FogCast-Konstanz/weather-station-pico/README.md

# Raspberry Pi Pico 2 Wetterstation

Dieses Repository enthält den MicroPython-Code für eine autarke, modulare Wetterstation auf Basis des Raspberry Pi Pico 2. Das System erfasst Umweltparameter (Temperatur, Luftfeuchtigkeit, Luftdruck) sowie Bewegungsdaten (IMU) und berechnet einen dynamisch korrigierten UV-Index.

## 📂 Projektstruktur

* `main.py`: Die Hauptausführungsschleife (nicht-blockierend)[cite: 10].
* `config.py`: Zentrale Konfigurationsdatei für Intervalle, Standortdaten und Pin-Mappings.
* `drivers/`: Hardware-spezifische MicroPython-Treiber für AS7331, MPU6886, QMP6988, SHT30 sowie die Sonnenstandsberechnung[cite: 12, 13, 14, 15, 16].
* `tools/`: Hilfsskripte, insbesondere `i2c_pin_scan.py` zur Ermittlung verdeckter I²C-Pins am Grove Shield[cite: 9].
* `docs/`: Projektdokumentation, Hardware-Aufbau und Gehäuseskizzen.

## 🚀 Installation & Setup

1. **MicroPython flashen:** Stelle sicher, dass auf dem Pico 2 die aktuelle MicroPython-Firmware installiert ist.
2. **Dateien übertragen:** Öffne Thonny (oder ähnliches) und kopiere alle Dateien und Ordner (außer `.git` und `docs/`) auf das Hauptverzeichnis (`/`) des Pico 2.
3. **SoftI²C-Pins ermitteln:** Da die zweite Signalader bei den Grove-Ports `A2` (IMU) und `D20` (UV) je nach Shield variieren kann, führe einmalig das Diagnose-Skript aus:
   ```python
   import tools.i2c_pin_scan
   tools.i2c_pin_scan.find_sensor("A2", expected_address=0x68)
   tools.i2c_pin_scan.find_sensor("D20", expected_address=0x74)
4. **Messwerte überprüfen:** Wenn die Skripte auf den Pico hochgeladen sind, können die ersten Messwerte auf der Konsole von dem PC ausgegeben werden. Hierbei können die Messwerte auf realitätsnahe Werte überprüft werden.

## ⏭️ Aktueller Stand / Weitere Schritte für das kommende Team

Momentan befindet sich der Aufbau der Sensorenanlage in den finalen Schritten. 

### Montage

Die Montage der 3D-Druck Teile und den Sensoren wir in diesem Repository unter folgenden Link erläutert:
https://github.com/FogCast-Konstanz/weather-station-pico/tree/main/docs/3D-Druck_Aufbau

### Die Stromversorgung

- Verwendete Komponenten:
   - Mikrocontroller: **Raspberry Pi Pico 2** 
   - Schaltmodul: **Seeed Studio Grove 2-Kanal-Relaismodul** (im transparenten Schutzgehäuse).
      - Verwendet zwei Songle SRD-05VDC-SL-C Relais (5V-Spulenspannung).
      - Schalteleistung: max. 10 A bei 250 V AC (Wechselstrom) bzw. 10 A bei 30 V DC (Gleichstrom).

- Verbindung & Funktion:
   - Verkabelung: Das Relaismodul ist über ein 4-adriges Kabel (Signal, 5V, GND) mit einem Steckplatz des Pico-Shields verbunden.
   - Funktionsweise: Das Relais fungiert als elektronisch gesteuerter Schalter. Der Raspberry Pi Pico 2 kann über einen digitalen Ausgang ein Steuersignal an das Modul senden, um den Stromkreis auf der Lastseite (Schraubklemmen am Relais) zu schließen oder zu öffnen.
   - Sicherheit: Das Modul verfügt über eine integrierte Optokoppler-Isolierung, die den empfindlichen Mikrocontroller vor gefährlichen Spannungsspitzen und Rückströmen aus dem Laststromkreis schützt.
   - Bei einer vollständigen Verbindung zwischen dem Raspberry Pi Pico 2 und dem Seeed Studio Grove 2-Kanal-Relaismodul kann diese an ein herkömmliches Stromnetz (230 V) angeschlossen werden. Dazu haben wir auf dem F-Gebäude Dach an der mittleren Plattform ein Stromkabel verlegt, der die Sensoranlage / Ceilometer damit bedienen soll.

### Die Sensoren sind mit dem Raspberry Pi Pico 2 wie folgt verbunden:

| Sensor | Grove-Port | Pico-GPIO (SDA / SCL) | Bus-Typ |
| :--- | :--- | :--- | :--- |
| SHT30 (intern) | I2C0 | GP8 / GP9 | Hardware I2C(0) |
| QMP6988 | I2C0 | GP8 / GP9 | Hardware I2C(0) |
| SHT30 (extern) | I2C1 | GP6 / GP7 | Hardware I2C(1) |
| MPU6886 (IMU) | A2 | GP28 / `<config.MPU6886_SCL_PIN>` | SoftI2C |
| AS7331 (UV) | D20 | GP20 / `<config.AS7331_SCL_PIN>` | SoftI2C |

Diese Verkabelung ist in 'main.py' im Code wiederzufinden, dementsprechend kann man dies im Code und physisch verändern, wenn man das möchte.

### Datenübertragung

Zusammen mit der zuständigen Abteilung der HTWG haben wir ein LAN-Kabel für die Datenübertragung vom F-Gebäude-Dach in den Raum **F-222** gelegt. Für den Zugang zu dem Raum ist Prof. Rebholz unsere Ansprechperson gewesen. Der Zugang wurde über den Anschluss **C 10 C2** für das HTWG-Netzwerk freigelegt, für eine problemlose Datenübertragung. Leider konnten wir diese Datenübertragung noch nicht testen. Hierfür war *Robert Breuer* ein guter Ansprechpartner und könnte für die Implementierung vermutlich eine große Hilfe sein. Die Netzwerk Config, die man beim Raspberry Pi dafür setzen muss lautet:
- **141.37.159.38/22**
- **141.37.156.254**

Wenn man die Config einstellt und die Hardware dementsprechend ans Netzwerk anschließt sollte die Verbindung aufgebaut werden können. Diese Daten können dann abgerufen und in die Datenbank eingepflegt werden.

### 🔌 Ersatzlösung: Standalone-Anbindung via USB & InfluxDB

Da aktuell kein bzw. bedingt das Ceilometer zur Verfügung steht, kann die Pico-2-Wetterstation bis zur finalen Integration über eine lokale USB-Schnittstelle direkt an den Raspberry Pi einer bestehenden Wetterstation angebunden werden.

1. Datenquelle (Pico 2): Die main.py auf dem Pico 2 gibt die gemessenen und korrigierten Sensordaten (UV-Index, Temperatur, Feuchte, Luftdruck, IMU) bei jeder Messrunde als JSON- bzw. Key-Value-String über die serielle USB-Schnittstelle (sys.stdout) aus.
2. Datenempfänger (Raspberry Pi Host): Der Raspberry Pi der bestehenden Wetterstation ist per USB-Kabel mit dem Pico 2 verbunden.
3. Bridge-Dienst: Ein kleiner Python-Background-Dienst (Daemon/Systemd-Service) auf dem Raspberry Pi liest den seriellen Port (/dev/ttyACM0) kontinuierlich aus und parst die eintreffenden Messwerte.
4. Persistierung: Der Dienst schreibt die strukturierten Datensätze direkt in die lokale oder netzwerkbasierte InfluxDB-Instanz der Wetterstation.

Architektur der Ersatzlösung:

```text
+-----------------------+     USB (Serial)     +-----------------------+    (Daemon Script)    +------------------+
| Raspberry Pi Pico 2   | -------------------> | Raspberry Pi (Host)   | --------------------> | InfluxDB         |
| (Wetterstation Code)  |                      | /dev/ttyACM0          |                       | (Datenbank)      |
+-----------------------+                      +-----------------------+                       +------------------+
```

Schritt-für-Schritt Einrichtung auf dem Raspberry Pi Host findet man unter dem Ordner: **without_ceilometer**
