FogCast-Konstanz/weather-station-pico/docs/Skizze_grober_Software-Ablauf.png

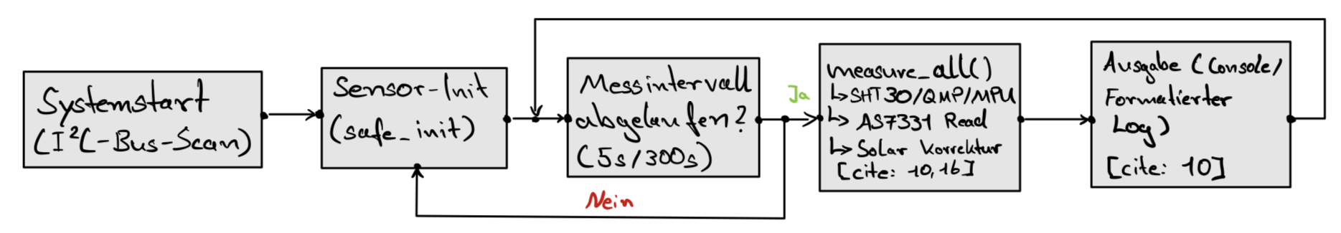
docs/Skizze_grober_Software-Ablauf.png
