FogCast-Konstanz/weather-station-pico/docs/3D-Druck_Aufbau/3D-Druckteile_AS7331/Halterung_fuer_UV-Sensor.STL-Körper.stl

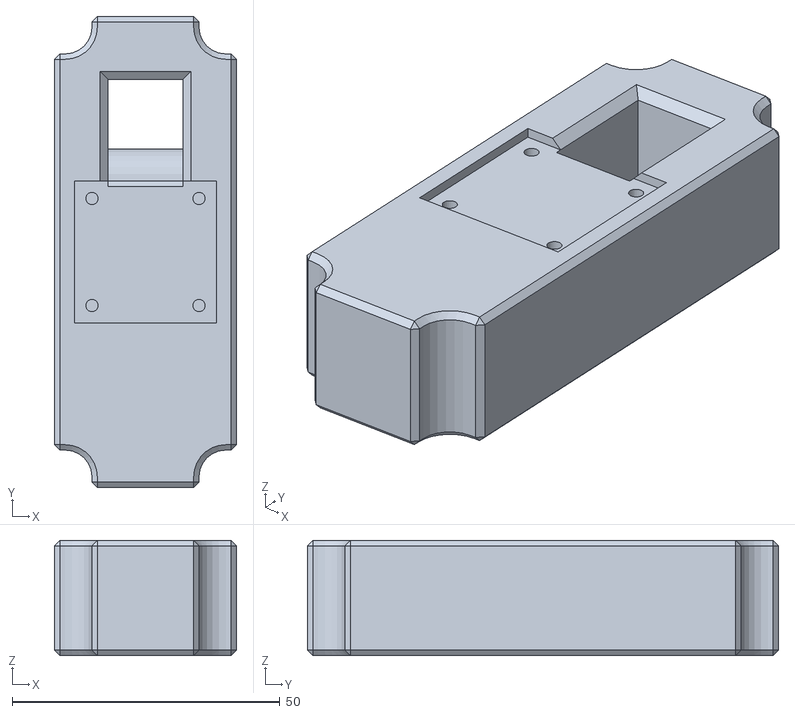
[picture p4: CAD file, 2026-09-01]
docs/3D-Druck_Aufbau/3D-Druckteile_AS7331/Halterung_fuer_UV-Sensor.STL-Körper.stl
34.0 x 88.0 x 21.5
