FogCast-Konstanz/weather-station-pico/docs/3D-Druck_Aufbau/3D-Druckteile_SHT30/Flansch_Lufttemperatursensor.stl

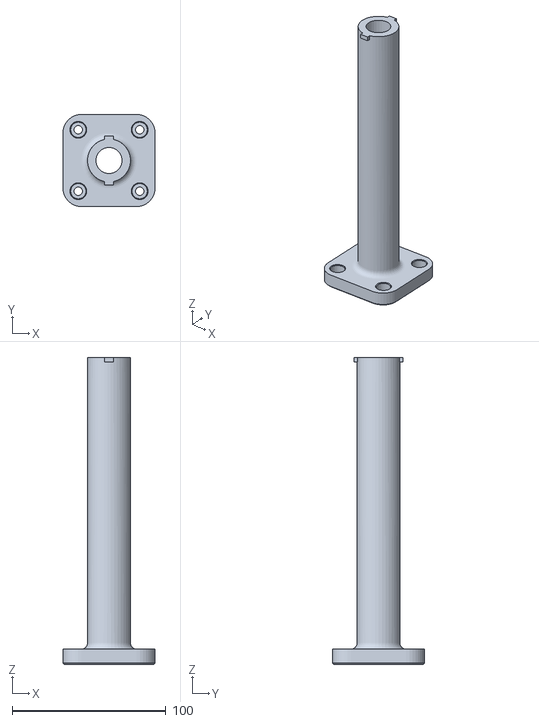
[picture p5: CAD file, 2026-09-01]
docs/3D-Druck_Aufbau/3D-Druckteile_SHT30/Flansch_Lufttemperatursensor.stl
60.0 x 60.0 x 200.0
