FogCast-Konstanz/weather-station-pico/docs/3D-Druck_Aufbau/3D-Druckteile_AS7331/Halterung_fuer_UV-Halterung-Körper.stl

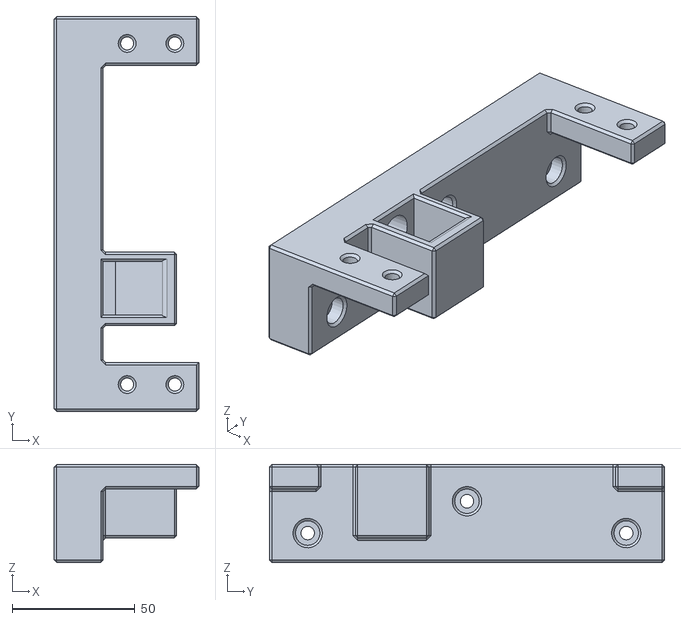
[picture p6: CAD file, 2026-09-01]
docs/3D-Druck_Aufbau/3D-Druckteile_AS7331/Halterung_fuer_UV-Halterung-Körper.stl
59.0 x 161.2 x 40.0
