FogCast-Konstanz/weather-station-pico/docs/3D-Druck_Aufbau/3D-Druckteile_SHT30/Abdeckung_Lufttemperatursensor_unten.stl

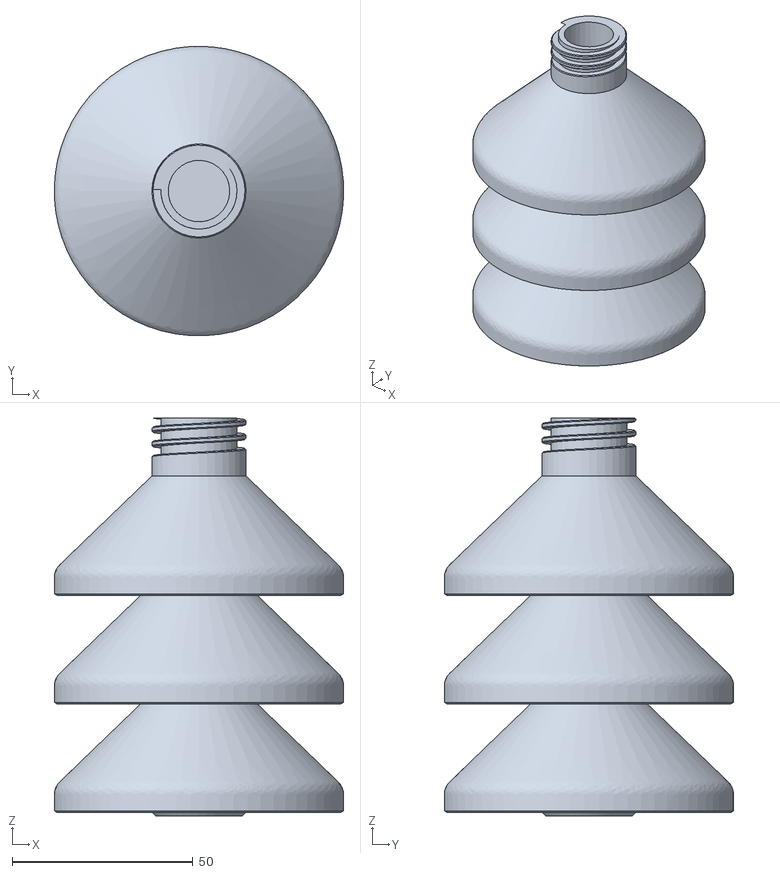
[picture p7: CAD file, 2026-09-01]
docs/3D-Druck_Aufbau/3D-Druckteile_SHT30/Abdeckung_Lufttemperatursensor_unten.stl
80.0 x 80.0 x 110.0
