FogCast-Konstanz/weather-station-pico/docs/3D-Druck_Aufbau/3D-Druckteile_AS7331/Halterung_fuer_Aluguss-Gehaeuse-Körper.stl

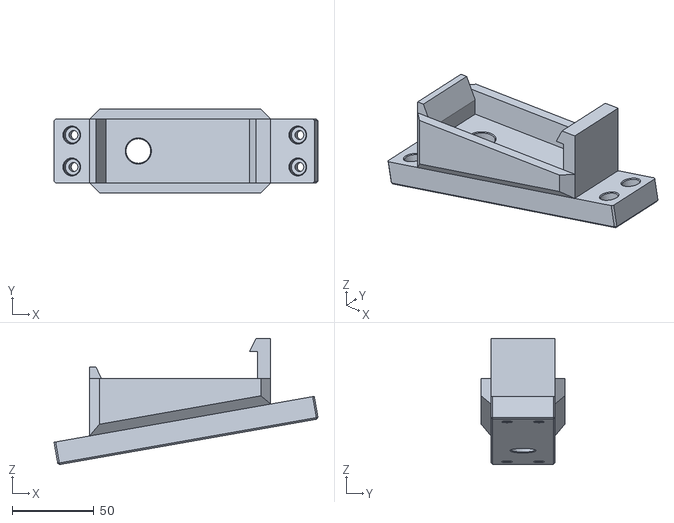
[picture p8: CAD file, 2026-09-01]
docs/3D-Druck_Aufbau/3D-Druckteile_AS7331/Halterung_fuer_Aluguss-Gehaeuse-Körper.stl
161.0 x 51.0 x 76.9
