FogCast-Konstanz/weather-station-pico/docs/3D-Druck_Aufbau/3D-Druckteile_SHT30/Abdeckung_Lufttemperatursensor_oben.stl

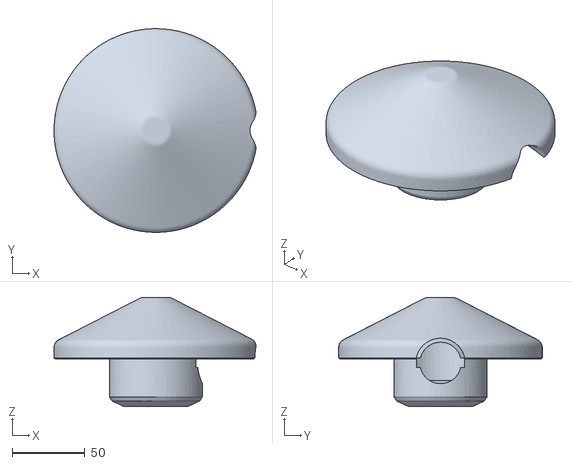
[picture p9: CAD file, 2026-09-01]
docs/3D-Druck_Aufbau/3D-Druckteile_SHT30/Abdeckung_Lufttemperatursensor_oben.stl
138.8 x 140.0 x 75.0
