FogCast-Konstanz/weather-station-pico/docs/3D-Druck_Aufbau/kurze_Erlaeterung.md

# 3D-Druck Teile
Die 3D-Druck Teile sind ein essenzieller Part bei der neuen Sensor-Implementierung. Sie ermöglichen eine stabile und individuellen Konstruktion für den Aufbau der Messstation.

## AS7331
Für die Konstruktion des UV-Sensors (AS7331) wurden drei Einzelteile über CAD konstruiert und wurde mit PETG (Polyethylenterephthalat-Glykol) gedruckt. Folgende Teile werden für den Aufbau benötigt:

- Halterung_fuer_UV-Sensor
- Halterung_fuer_Aluguss-Gehaeuse
- Halterung_fuer_UV-Halterung

## SHT30 (Extern)
Für die Konstruktion des SHT30-Sensors (extern) wurden drei Einzelteile über CAD konstruiert und wurde mit PETG (Polyethylenterephthalat-Glykol) gedruckt. Folgende Teile werden für den Aufbau benötigt:

- Flansch_Lufttemperatursensor
- Abdeckung_Lufttemperatursensor_oben
- Abdeckung_Lufttemperatursensor_unten
