FogCast-Konstanz/weather-station-pico/docs/3D-Druck_Aufbau/3D-Druckteile_SHT30/kurze_beschreibung_zusammenbau.md

# Kurze Beschreibung nach dem Drucken der (stl) Teile

1. Die Verkabelung mit dem Sensor durch den *Flansch_Lufttemperatursensor* und der *Abdeckung_Lufttemperatursensor_oben* durchführen.
2. Den *Flansch_Lufttemperatursensor* mit der *Abdeckung_Lufttemperatursensor_oben* mit dem konstruierten Verschluss zusammen verbinden.
3. Den *Flansch_Lufttemperatursensor* an die Holzkiste bei den vorhergesehenen Bohrungen befestigen.
4. Die *Abdeckung_Lufttemperatursensor_unten* kann nun mit dem Gewinde an die obere Abdeckung geschraubt werden. ACHTUNG: Auf den Sensor und dessen Verkabelung achten, sodass keine Beschädigungen beim montieren entstehen
