FogCast-Konstanz/weather-station-pico/(commit log)

2026-09-01 Revise README for Raspberry Pi Pico 2 weather station
    Updated the README to reflect the new project structure and installation instructions for the Raspberry Pi Pico 2 weather station.
2026-09-01 Add hardware setup and wiring documentation
    Document the hardware setup and wiring for the system, detailing the I²C buses and physical connections.
2026-09-01 Add project documentation for FogCast and sensors
    Added comprehensive documentation for the FogCast project, detailing the project goals, sensor overview, system architecture, physical challenges, calibration methods, software flow, and solar position correction.
2026-09-01 Document 3D-printed parts for sensor implementation
    Added detailed descriptions of 3D-printed parts for AS7331 and SHT30 sensors, including required components.
2026-09-01 Add assembly instructions for 3D printed SHT30 parts
    Added a brief assembly description for the 3D printed parts.
2026-09-01 Clarify title in assembly description
    Updated the title to specify that it refers to the (stl) parts.
2026-09-01 Add assembly instructions for 3D printed parts
    Added a step-by-step guide for assembling the 3D printed parts, including placement and wiring instructions for the UV sensor and aluminum housing.
2026-09-01 Update assembly instructions for SHT30 components
2026-09-02 Fix typos in i2c_pin_scan.py documentation
    Corrected minor typos in comments and usage instructions.
    [i2c_pin_scan.py]
2026-09-02 Fix docstring formatting in mpu6886.py
    Corrected formatting and removed duplicate text in docstring.
    [mpu6886.py]
2026-09-02 Fix formatting in SHT30 driver documentation
    [sht30.py]
2026-09-02 Fix important notes in solar_position.py
    Correct important notes regarding sensor calibration and time synchronization requirements.
    [solar_position.py]
2026-09-02 Improve comments and documentation in config.py
    Updated comments for clarity and added section on physical wiring.
2026-09-02 Refine comments and sensor documentation in main.py
    Updated comments and documentation for clarity and accuracy.
2026-09-02 Revise sensor wiring documentation in config.py
    Updated comments regarding physical wiring for sensors.
2026-10-29 Update README with sensor and power supply details
    Added details about sensor setup, power supply, and wiring for Raspberry Pi Pico 2.
2026-10-29 Update README with relay module connection details
    Added connection details for the Raspberry Pi Pico 2 and Grove 2-channel relay module, including safety information and wiring instructions.
2026-10-29 Revise sensor connections and document data transfer
    Updated sensor connection details and added data transmission section.
2026-11-01 Abschlussbericht-UV_und_weitere_Sensoren
    Eine Erweiterung der Projekt Doku.
2026-11-01 Document standalone USB connection for Pico-2
    Added a section on standalone connection via USB and InfluxDB for the Pico-2 weather station.
2026-11-01 Clarify standalone USB connection setup for Pico-2
    Updated the explanation for the standalone connection of the Pico-2 weather station to the Raspberry Pi, detailing the data flow and architecture.
2026-11-01 Update README with setup instructions for Raspberry Pi
    Added instructions for step-by-step setup on Raspberry Pi Host.
2026-11-01 Update README with setup instructions for Raspberry Pi
    Added section for step-by-step setup instructions on Raspberry Pi Host.
2026-11-01 Add Pico to InfluxDB data ingestion script
2026-11-01 Add systemd service configuration for Pico 2 bridge
2026-11-01 Add commands to enable and start pico-bridge service
2026-11-01 Create 00_Kurze_Erklaerung.md for sensor setup
    Added a brief explanation for sensor setup without Ceilometer.
2026-11-01 Update instructions for sensor setup without Ceilometer
    Added steps for creating a bridge script and setting it up as a systemd service.
